WSDSB-hub/EmbodiedVision/DRL-Obstacle-Avoidance/drl design.md

## 方向三：基于深度强化学习的自主导航

### 目标
在PyBullet物理仿真环境中，使用PPO（Proximal Policy Optimization）深度强化学习算法训练一个智能体，使其学会在障碍物环境中自主避障并到达目标位置。探索AI与机器人控制的交叉领域，为后续Sim-to-Real部署奠定基础。

### 为什么选择强化学习？
在方向六中，避障决策使用的是基于规则的状态机：检测到障碍物在左侧就右转，在右侧就左转。这套规则在简单场景下有效，但存在三个局限：
1. 无法处理复杂场景（如多个障碍物同时出现）。
2. 规则的阈值（安全距离0.5米）需要人工调试，泛化能力差。
3. 遇到未曾预料的场景时完全无法应对。

强化学习的核心优势在于：不需要人工编写规则，智能体通过在环境中反复试错，自己学会最优策略。这正是从"人工编程"走向"自主智能"的关键一步。

### 技术架构

#### 仿真环境：PyBullet
选择PyBullet而非Gazebo的原因：
- 轻量级，安装简单，无需ROS依赖。
- 支持DIRECT模式（无GUI渲染），训练速度比Gazebo快10倍以上。
- 内置`plane.urdf`、`r2d2.urdf`、`cube_small.urdf`等基础模型，开箱即用。

#### 强化学习框架：Gymnasium + Stable-Baselines3
- **Gymnasium**：OpenAI维护的强化学习环境标准接口。自定义环境只需实现`reset()`和`step()`两个方法，即可无缝对接所有主流算法。
- **Stable-Baselines3**：封装了PPO、SAC、A2C等算法的稳定实现。我们选择PPO的原因：
  - 适合离散动作空间（本项目的3个动作）。
  - 训练稳定，不易崩溃（相比DQN等值函数方法）。
  - 超参数不敏感，适合初次尝试强化学习的新手。

#### 状态空间设计
状态空间是3维连续向量，范围[0, 10]，代表小车前方三个方向（左前、正前、右前）的距离传感器读数。设计考量：
- 3维是最小可行的观测维度。更高维度（如摄像头图像）需要CNN策略网络，训练成本大幅增加。
- 距离传感器与实物小车的深度估计输出天然对应，便于后续Sim-to-Real迁移。

#### 动作空间设计
动作空间是3个离散动作：0=前进，1=左转，2=右转。设计考量：
- 与实物小车的控制指令（'w', 'a', 'd'）一一对应。
- 离散动作比连续动作（如目标转速值）更容易训练，收敛更快。

#### 奖励函数设计
奖励函数是强化学习中最关键的设计决策。本环境的奖励规则：
- 到达终点（x>5.0）：+10
- 碰撞障碍物（距离<0.3米）：-10
- 正常前进：`-0.1 × min_dist + 1.0`

第三项的设计逻辑：距离障碍物越远，奖励越高（最高+1.0）。乘以0.1是为了让单步奖励保持在较小范围，避免梯度爆炸。+1.0的偏置确保前进过程获得正向激励，防止智能体原地不动。

### 训练过程

训练脚本 `train_drl.py` 的核心参数：
- **算法**：PPO
- **策略网络**：MlpPolicy（全连接神经网络，2层64单元）
- **学习率**：0.0003（默认值，适合大多数场景）
- **n_steps**：1024（每次更新前收集的步数）
- **总训练步数**：100,000

训练在PyBullet的DIRECT模式下运行，无需GUI渲染。在我的笔记本上完成10万步训练仅需几分钟，比Gazebo仿真快一个数量级。

### 测试结果

运行 `test_drl.py` 进行200步测试，关键数据：
- **累计奖励**：+62.04
- **终止原因**：到达终点（第90步获得+10奖励）
- **主要行为**：模型选择了以右转为主的绕行策略

累计奖励远高于0，说明模型确实学会了避障。但它并没有掌握灵活转向——大多数时候它只是"一直右转"。这不代表训练失败，而是反映了当前环境设计的局限性。

### 诚实分析：模型的局限与根源

模型学到的策略之所以比较单一，根源在于仿真环境过于简单：
1. 只有2个静态障碍物，且位置范围有限。
2. 观测空间只有3维距离值，缺少方向信息，模型无法判断障碍物在左边还是右边。
3. 10万步训练对于复杂策略可能不够充分。

但这并不意味着方向三没有价值。恰恰相反，这个过程完整展示了强化学习项目的标准流程——环境设计、算法选择、训练监控、结果分析、改进方向——这正是研究生阶段做科研的核心能力。

### 后续改进方向

1. **丰富环境复杂度**
   - 增加障碍物数量（从2个到5-10个）。
   - 随机化障碍物的初始位置和大小。
   - 引入动态障碍物（移动的方块）。

2. **改进观测空间**
   - 将3维距离改为5维或7维，覆盖更广的前方视野。
   - 加入小车当前位置和目标位置，让模型学会全局路径规划。

3. **Sim-to-Real部署**
   - 将训练好的PPO模型导出为ONNX格式。
   - 在实物小车上加载模型，用深度估计的输出作为观测输入。
   - 对比规则式避障与强化学习避障的成功率和路径效率。

4. **算法升级**
   - 尝试SAC（Soft Actor-Critic），适合连续动作空间，可实现更平滑的转向。
   - 使用LSTM策略网络处理时间序列信息。

### 产出
- `models/ppo_avoidance_model.zip`：训练好的PPO模型
- `src/drl_avoidance_env.py`：自定义Gym环境（含完整的状态/动作/奖励定义）
- `src/train_drl.py`：训练脚本（含PPO超参数配置）
- `src/test_drl.py`：测试脚本（输出每步动作和累计奖励）
- `src/pybullet_test.py`：仿真环境验证脚本
- `images/pybullet_env.png`：PyBullet仿真环境截图
