WSDSB-hub/EmbodiedVision/05-Visual-Perception/yolo_detection image/3745dec2737d3145f0a43bfdfe77ebf4.png

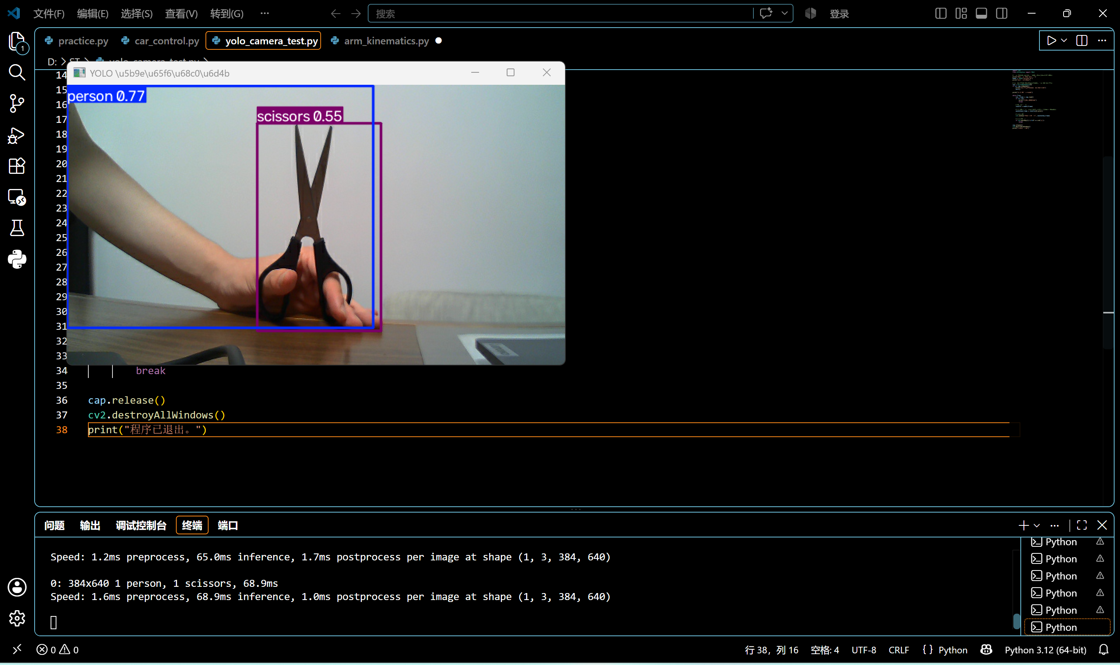
05-Visual-Perception/yolo_detection image/3745dec2737d3145f0a43bfdfe77ebf4.png
