WSDSB-hub/EmbodiedVision/05-Visual-Perception/yolo_detection image/10291ce72935a3f45005688cc83b20e0.png

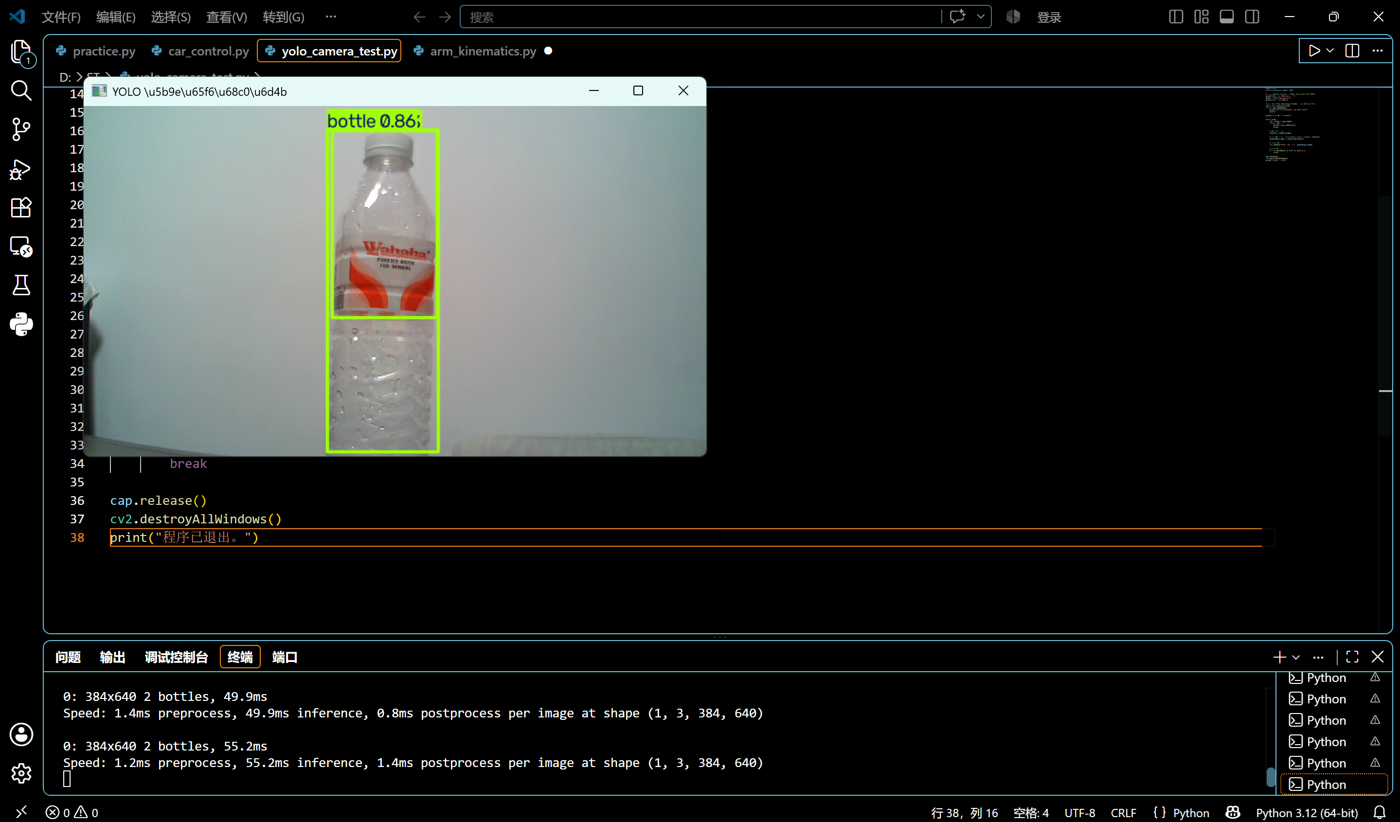
05-Visual-Perception/yolo_detection image/10291ce72935a3f45005688cc83b20e0.png
