WSDSB-hub/EmbodiedVision/DRL-Obstacle-Avoidance/pybullet_env.png

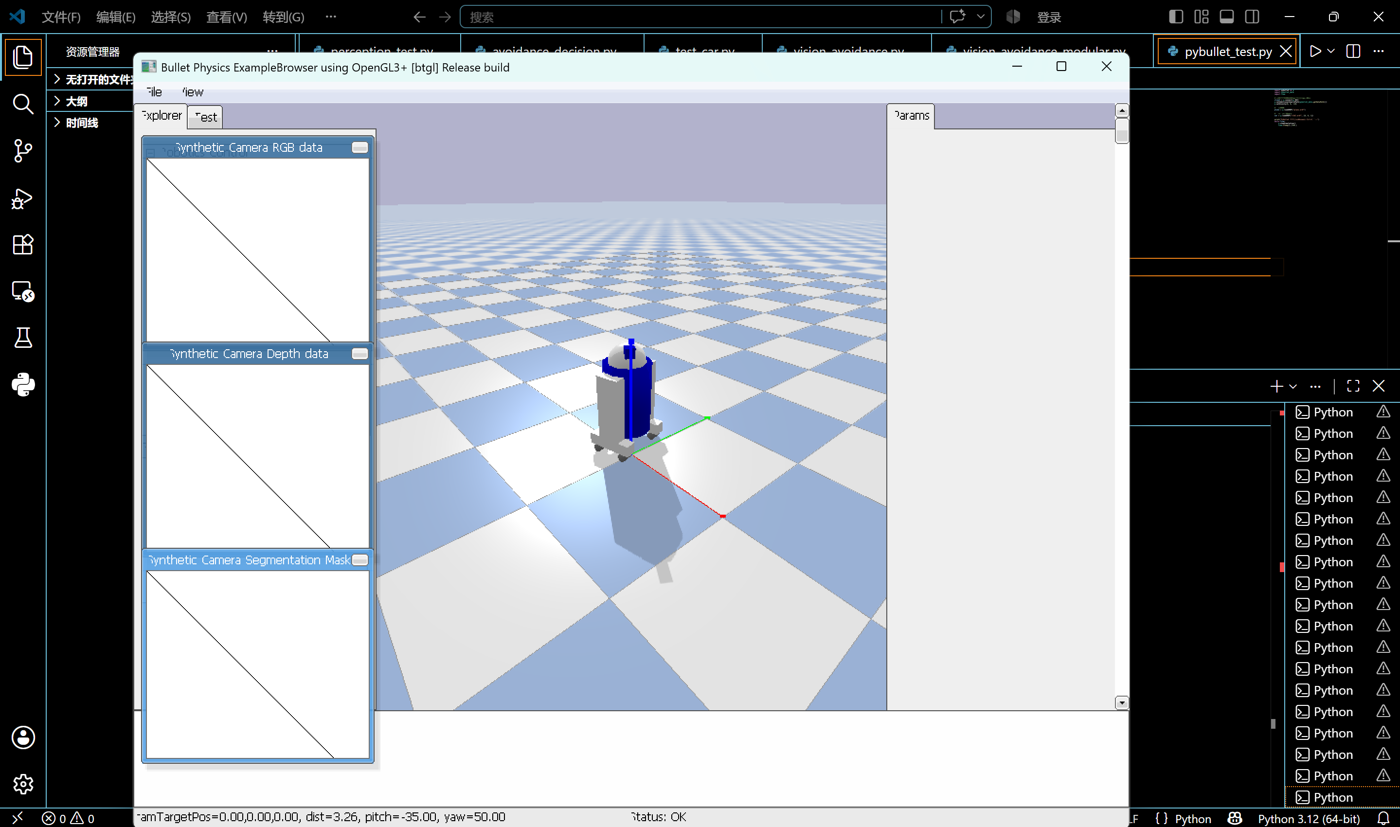
DRL-Obstacle-Avoidance/pybullet_env.png
