WSDSB-hub/EmbodiedVision/vision_pkg/vision_pkg/image publisher and subscriber.png

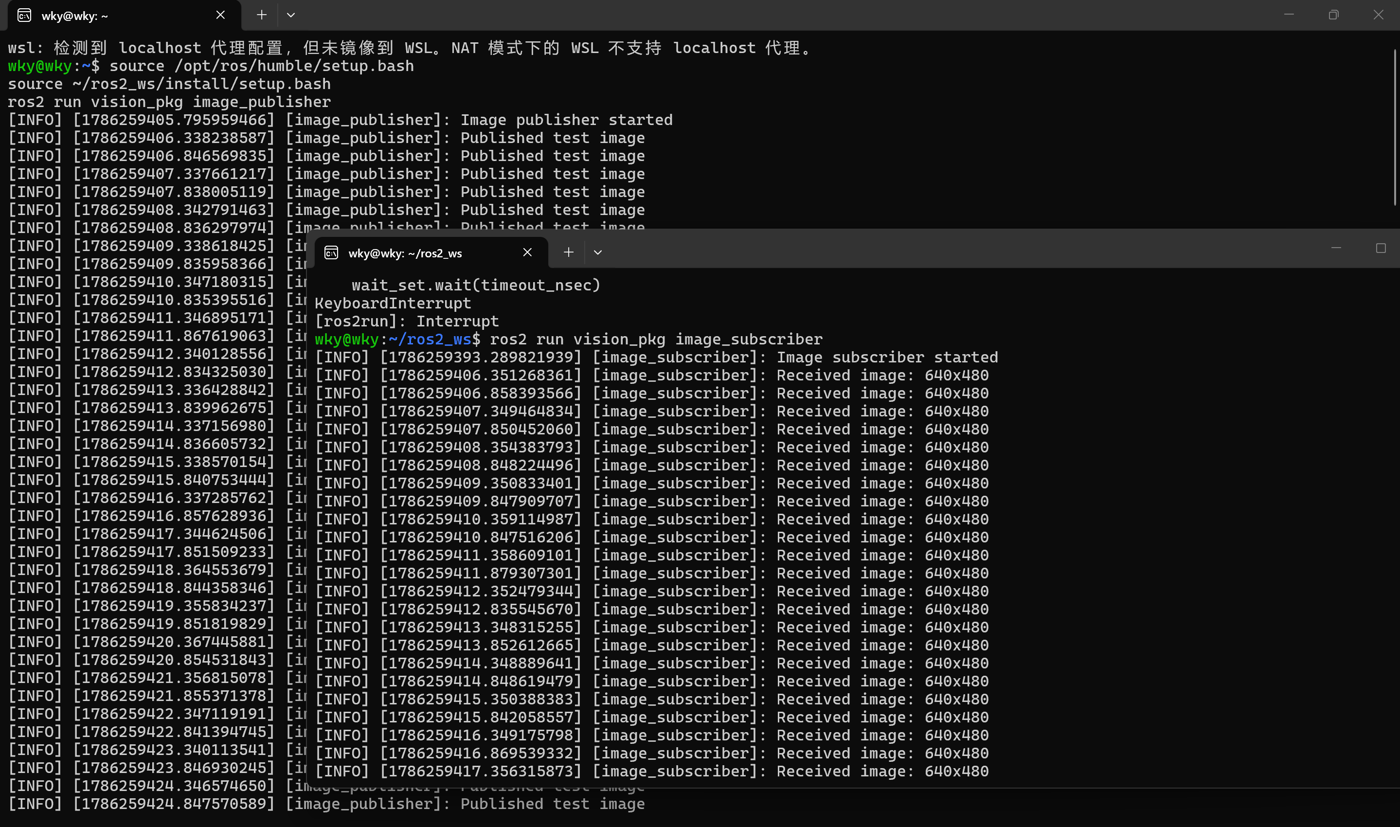
vision_pkg/vision_pkg/image publisher and subscriber.png
