WSDSB-hub/EmbodiedVision/01-Hardware-Setup/hardware setup(2).png

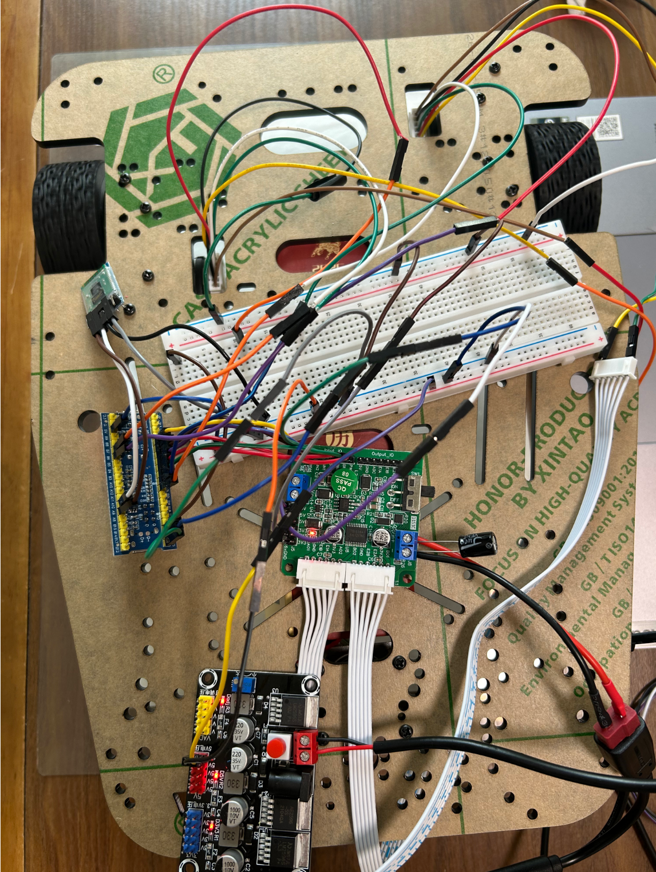
01-Hardware-Setup/hardware setup(2).png
