WSDSB-hub/EmbodiedVision/04-Serial-Protocol/serial protocol test.png

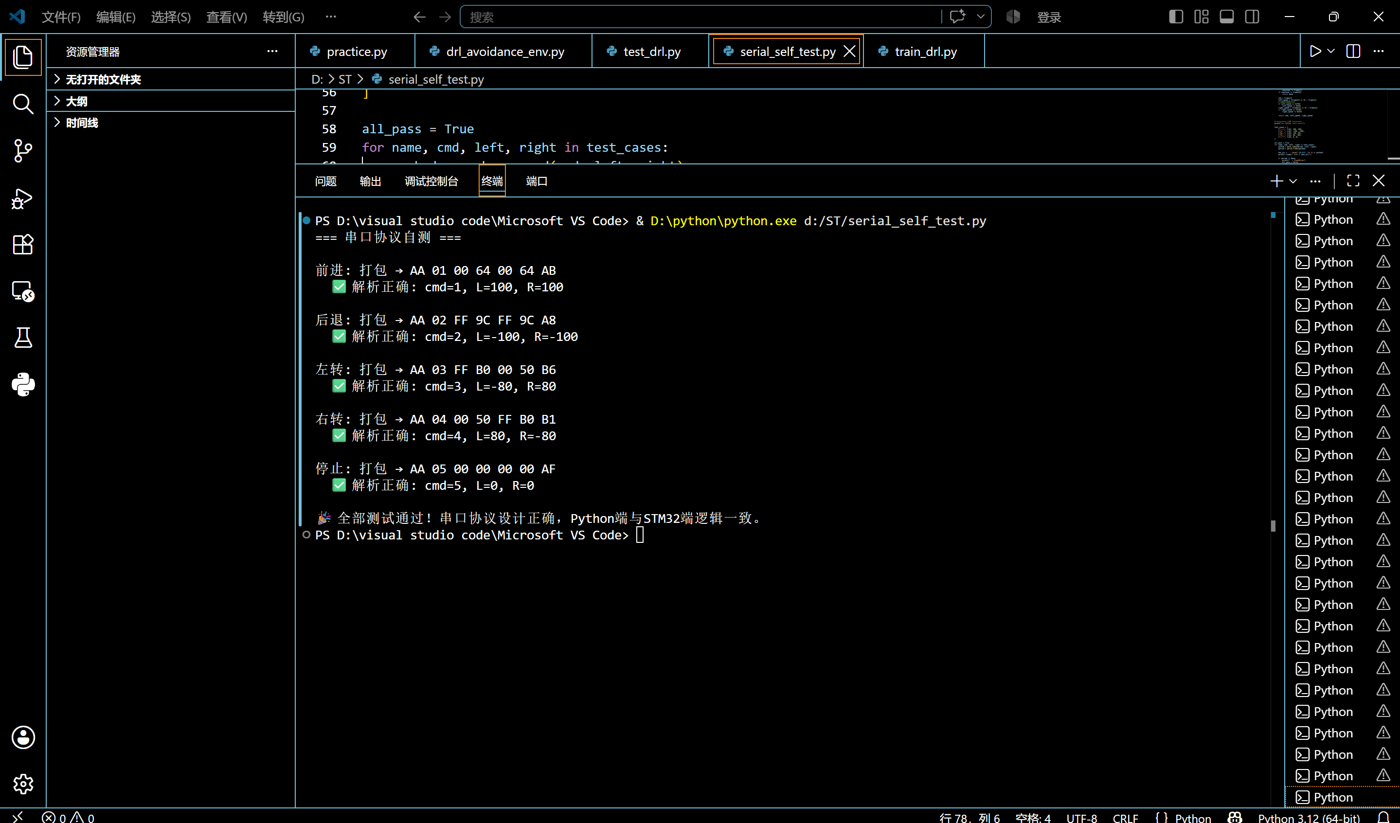
04-Serial-Protocol/serial protocol test.png
