WSDSB-hub/EmbodiedVision/05-Visual-Perception/depth_result image/5b46ab0efe99fd05fd456c35dd674b6e.png

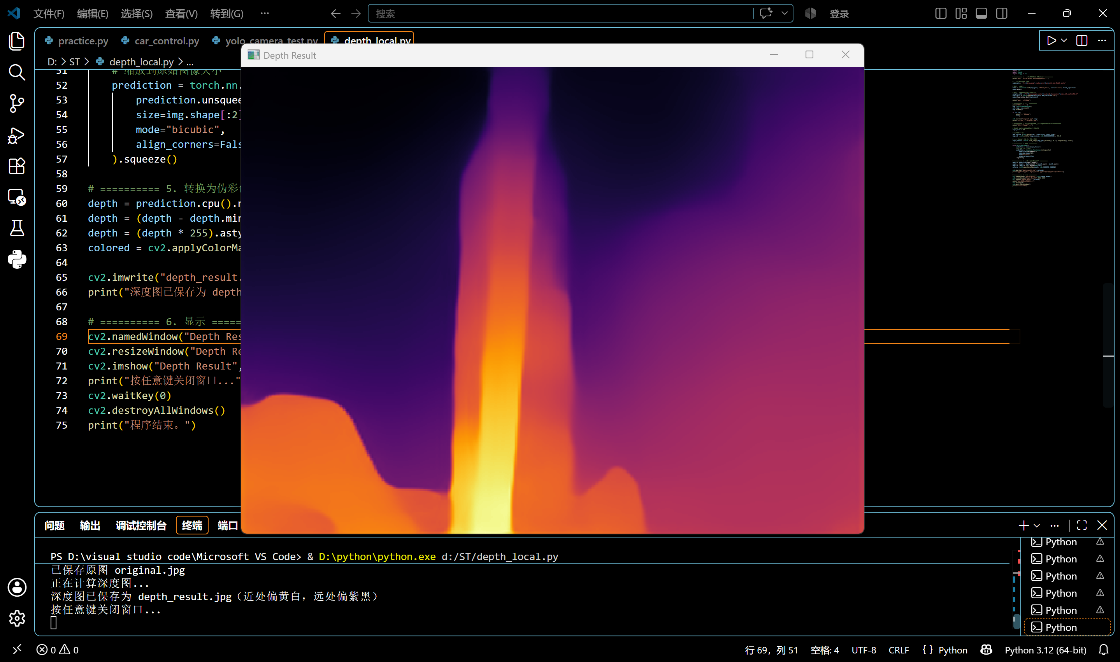
05-Visual-Perception/depth_result image/5b46ab0efe99fd05fd456c35dd674b6e.png
