WSDSB-hub/EmbodiedVision/05-Visual-Perception/depth_result image/c488f6ab571cf79846c9f93154ac484e.png

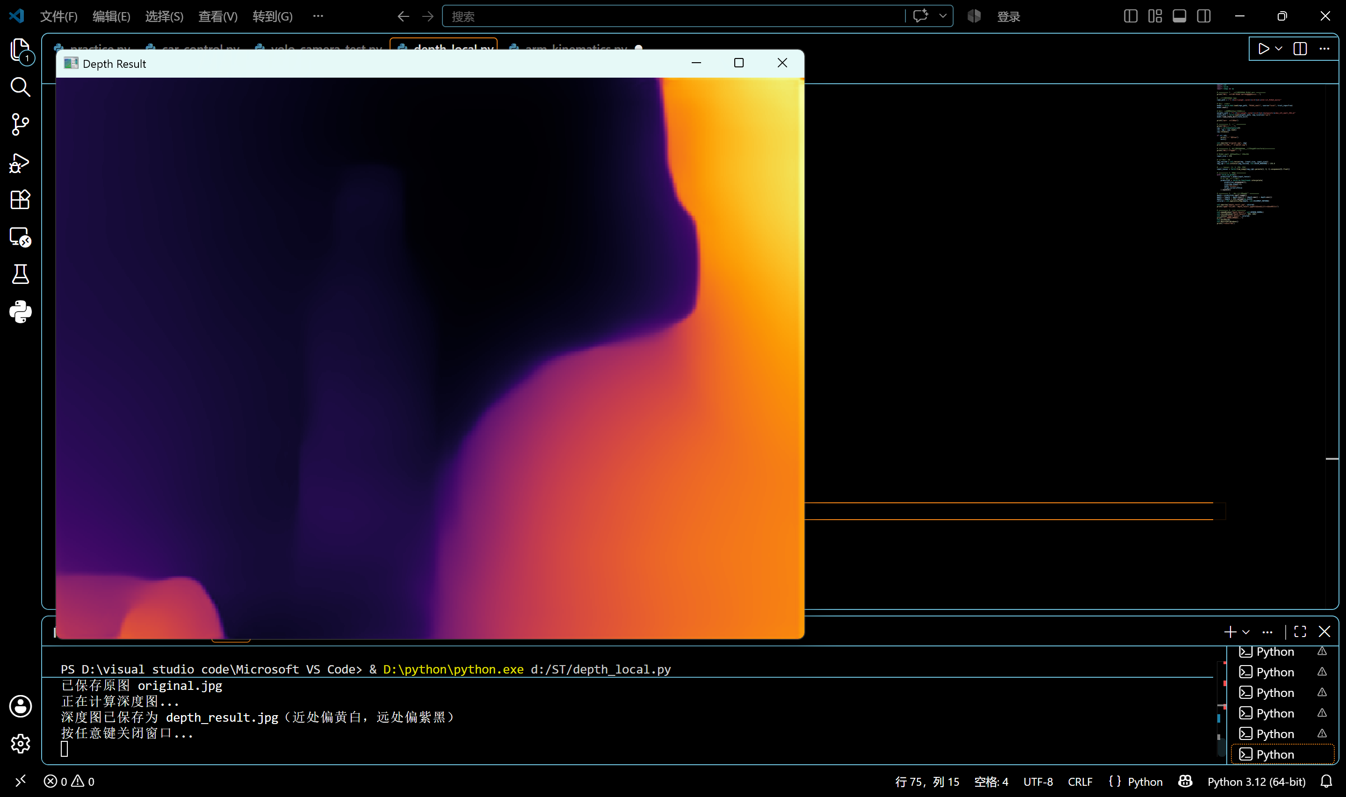
05-Visual-Perception/depth_result image/c488f6ab571cf79846c9f93154ac484e.png
