WSDSB-hub/EmbodiedVision/05-Visual-Perception/depth_result image/ed015eefcad42e6531cd074528ec0791.png

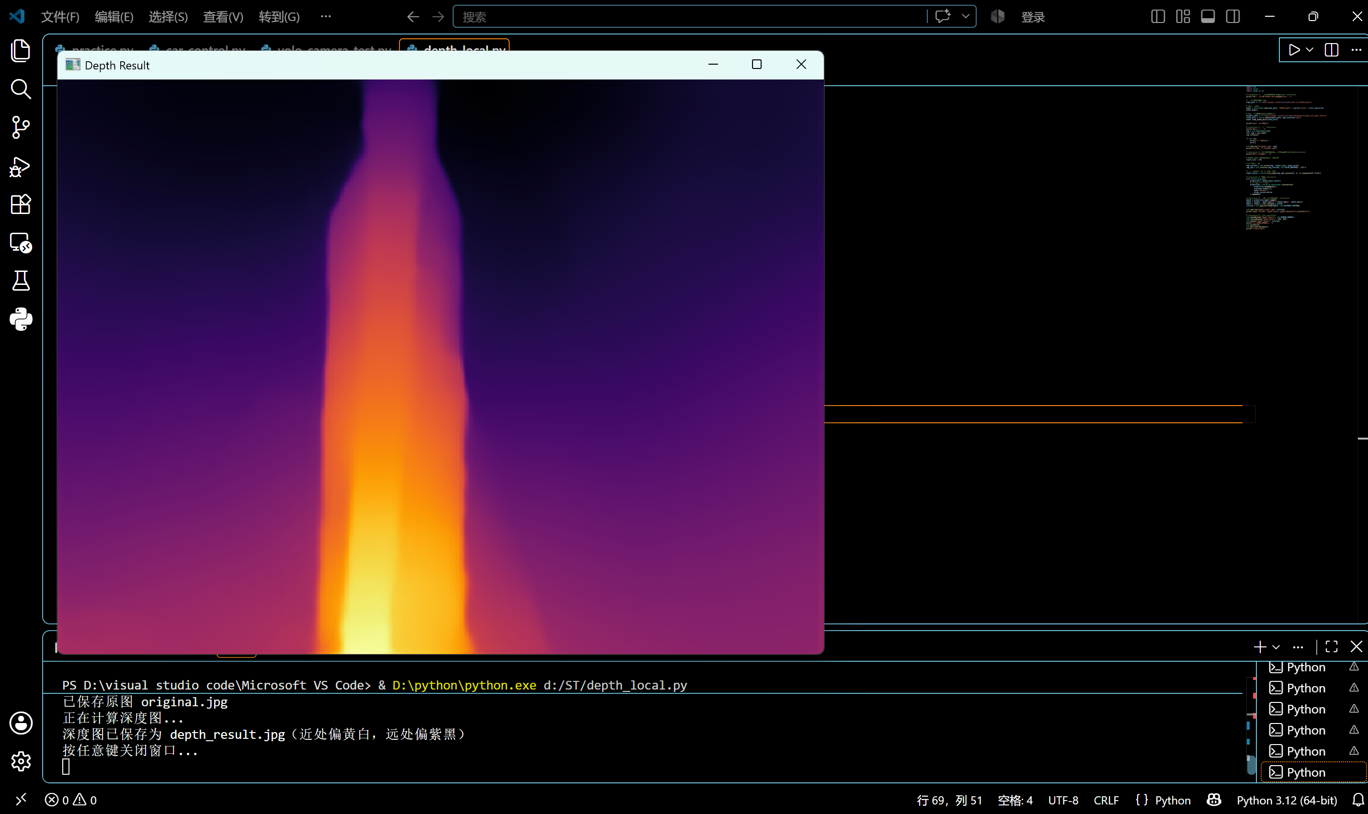
05-Visual-Perception/depth_result image/ed015eefcad42e6531cd074528ec0791.png
