WSDSB-hub/EmbodiedVision/06-Autonomous-Avoidance/avoidance_result.png

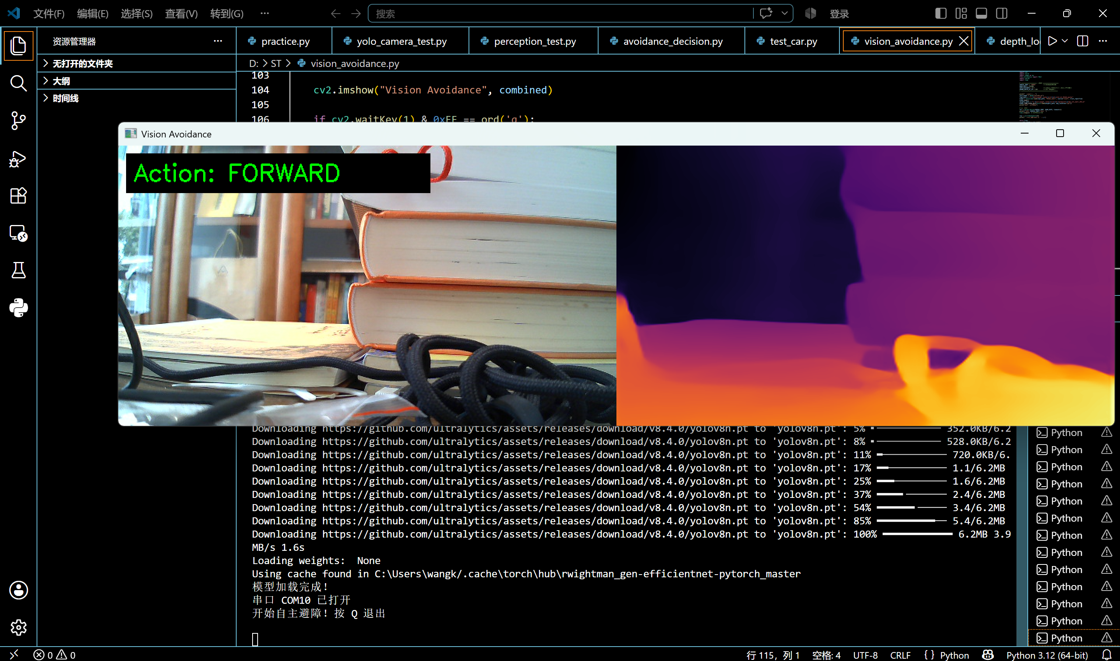
06-Autonomous-Avoidance/avoidance_result.png
