WSDSB-hub/EmbodiedVision/DRL-Obstacle-Avoidance/drl_test_result（1）.png

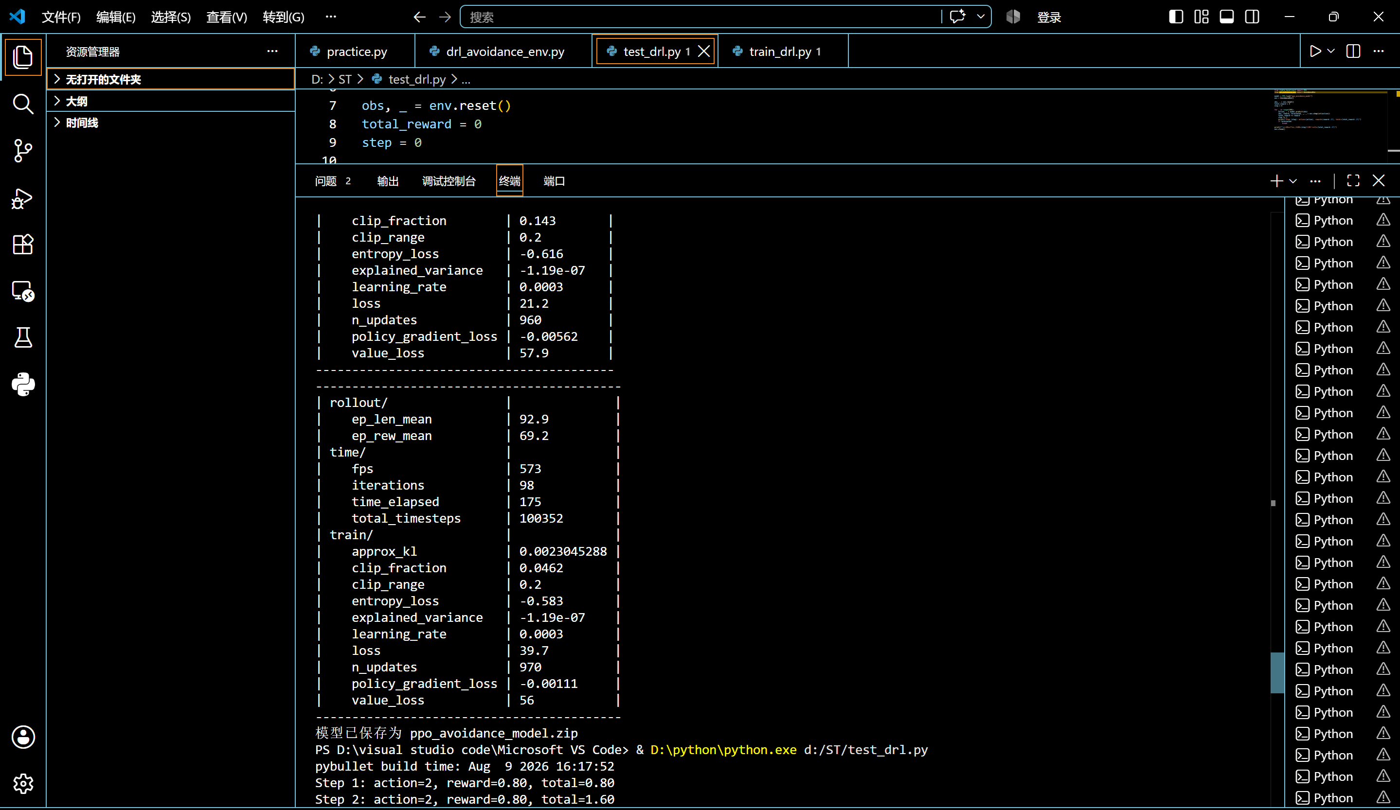
DRL-Obstacle-Avoidance/drl_test_result（1）.png
