WSDSB-hub/EmbodiedVision/DRL-Obstacle-Avoidance/drl_test_result（2）.png

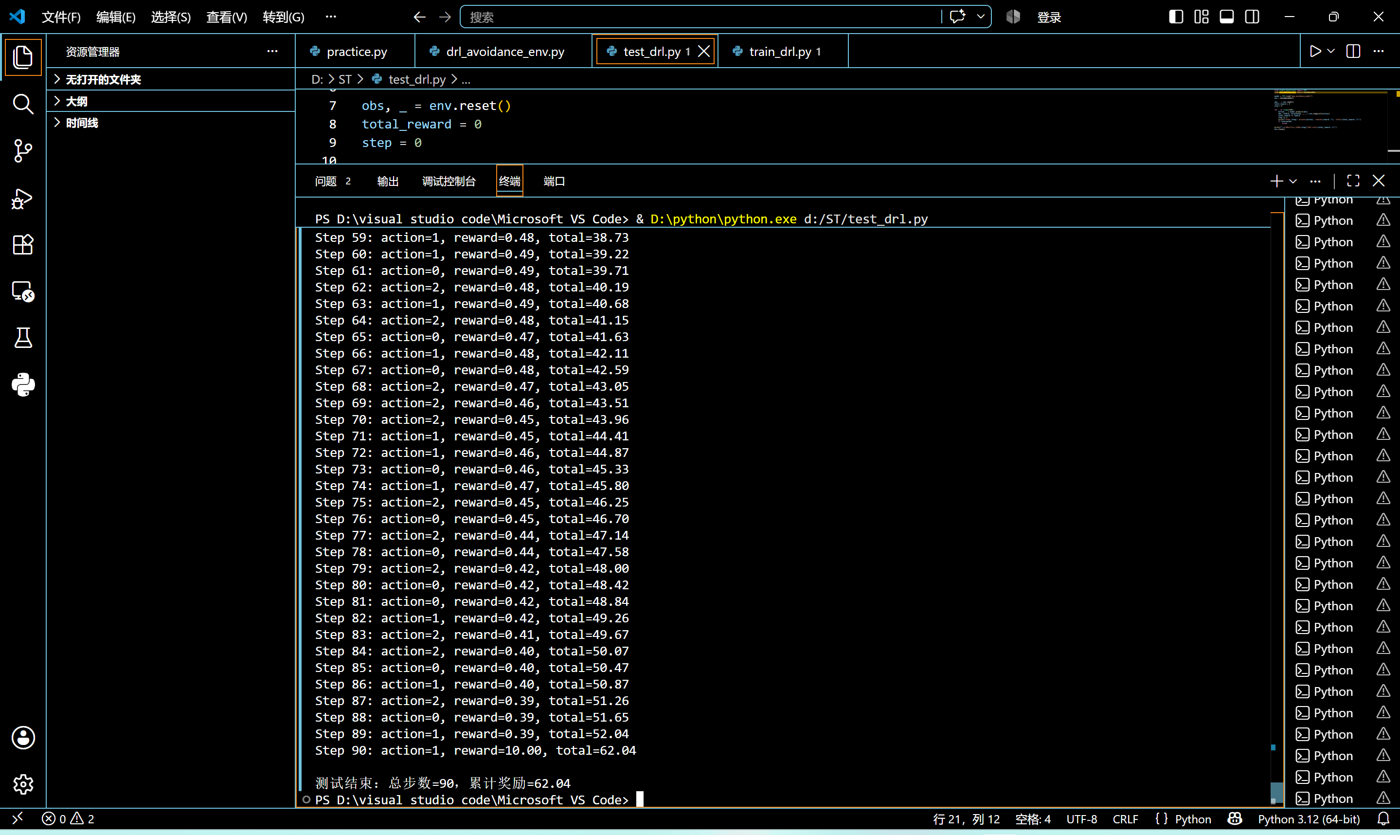
DRL-Obstacle-Avoidance/drl_test_result（2）.png
