WSDSB-hub/EmbodiedVision/04-Serial-Protocol/03_Car_Serial/Core/Src/main.c

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
/* Includes ------------------------------------------------------------------*/
#include "main.h"

/* USER CODE BEGIN Includes */
#include <stdio.h>
#include <string.h>
/* USER CODE END Includes */

TIM_HandleTypeDef htim1;
TIM_HandleTypeDef htim2;
TIM_HandleTypeDef htim3;
TIM_HandleTypeDef htim4;

UART_HandleTypeDef huart1;

/* USER CODE BEGIN PV */
typedef struct {
    float Kp, Ki, Kd;
    float target;
    float error, last_error;
    float integral;
    float output;
    float output_max;
} PID;

PID pid;
volatile float current_rpm = 0;
volatile uint8_t pid_ready = 0;
#define PULSES_PER_REV 1456.0f

// 串口接收缓冲区（用于轮询）
volatile uint8_t uart_rx_buf[7];
volatile uint8_t uart_rx_index = 0;
volatile uint8_t uart_rx_complete = 0;

/* USER CODE END PV */

void SystemClock_Config(void);
static void MX_GPIO_Init(void);
static void MX_TIM1_Init(void);
static void MX_TIM2_Init(void);
static void MX_TIM3_Init(void);
static void MX_TIM4_Init(void);
static void MX_USART1_UART_Init(void);
/* USER CODE BEGIN 0 */
void PID_Calc(PID *p, float current)
{
    if (p->target == 0.0f) {
        p->output = 0.0f;
        p->integral = 0.0f;
        p->last_error = 0.0f;
        return;
    }

    p->error = p->target - current;
    p->integral += p->error;
    if (p->integral > 500.0f) p->integral = 500.0f;
    if (p->integral < -100.0f) p->integral = -100.0f;

    float output = 275.0f;
    output += p->Kp * p->error;
    output += p->Ki * p->integral;
    output += p->Kd * (p->error - p->last_error);
    if (output > 900.0f) output = 900.0f;
    if (output < 0.0f)   output = 0.0f;

    p->output = output;
    p->last_error = p->error;
}

// 指令解析（统一用 pid）
void Parse_Command(void)
{
  if (uart_rx_complete)
  {
    uart_rx_complete = 0;
    uint8_t cmd = uart_rx_buf[1];
    int16_t left_speed = (uart_rx_buf[2] << 8) | uart_rx_buf[3];
    int16_t right_speed = (uart_rx_buf[4] << 8) | uart_rx_buf[5];

    switch (cmd)
    {
      case 0x01:
        pid.target = left_speed;
        HAL_GPIO_WritePin(GPIOA, GPIO_PIN_2, GPIO_PIN_SET);
        HAL_GPIO_WritePin(GPIOA, GPIO_PIN_3, GPIO_PIN_RESET);
        HAL_GPIO_WritePin(GPIOA, GPIO_PIN_4, GPIO_PIN_SET);
        HAL_GPIO_WritePin(GPIOA, GPIO_PIN_5, GPIO_PIN_RESET);
        break;
      case 0x05:
        pid.target = 0;
        break;
    }
  }
}
/* USER CODE END 0 */

/**
  * @brief  The application entry point.
  * @retval int
  */
int main(void)
{

  /* MCU Configuration--------------------------------------------------------*/

  /* Reset of all peripherals, Initializes the Flash interface and the Systick. */
  HAL_Init();

  /* Configure the system clock */
  SystemClock_Config();

  /* Initialize all configured peripherals */
  MX_GPIO_Init();
  MX_TIM1_Init();
  MX_TIM2_Init();
  MX_TIM3_Init();
  MX_TIM4_Init();
  MX_USART1_UART_Init();
  /* USER CODE BEGIN 2 */
  // 手动开启编码器引脚上拉
  GPIOA->ODR |= (GPIO_PIN_6 | GPIO_PIN_7);
  GPIOB->ODR |= (GPIO_PIN_6 | GPIO_PIN_7);

  // 启动编码器和PWM
  HAL_TIM_Encoder_Start(&htim3, TIM_CHANNEL_ALL);
  HAL_TIM_Encoder_Start(&htim4, TIM_CHANNEL_ALL);
  HAL_TIM_PWM_Start(&htim2, TIM_CHANNEL_1);
  HAL_TIM_PWM_Start(&htim2, TIM_CHANNEL_2);
  HAL_TIM_Base_Start_IT(&htim1);

  // PID参数
  pid.Kp = 2.5f;
  pid.Ki = 0.2f;
  pid.Kd = 0.1f;
  pid.target = 0.0f;
  pid.output_max = 999.0f;
  pid.integral = 0;
  pid.last_error = 0;

  // 方向：正转
  HAL_GPIO_WritePin(GPIOA, GPIO_PIN_2, GPIO_PIN_SET);
  HAL_GPIO_WritePin(GPIOA, GPIO_PIN_3, GPIO_PIN_RESET);
  HAL_GPIO_WritePin(GPIOA, GPIO_PIN_4, GPIO_PIN_SET);
  HAL_GPIO_WritePin(GPIOA, GPIO_PIN_5, GPIO_PIN_RESET);

  // 启动消息
  char *msg = "READY\r\n";
  HAL_UART_Transmit(&huart1, (uint8_t*)msg, strlen(msg), HAL_MAX_DELAY);
  /* USER CODE END 2 */

  /* Infinite loop */
  /* USER CODE BEGIN WHILE */
  while (1)
  {
	  // ========== 串口轮询接收 ==========
	    if (__HAL_UART_GET_FLAG(&huart1, UART_FLAG_RXNE))
	    {
	      char cmd = (char)(huart1.Instance->DR & 0xFF);

	      switch (cmd)
	      {
	        case 'w':  // 前进
	          HAL_GPIO_WritePin(GPIOA, GPIO_PIN_2, GPIO_PIN_SET);
	          HAL_GPIO_WritePin(GPIOA, GPIO_PIN_3, GPIO_PIN_RESET);
	          HAL_GPIO_WritePin(GPIOA, GPIO_PIN_4, GPIO_PIN_SET);
	          HAL_GPIO_WritePin(GPIOA, GPIO_PIN_5, GPIO_PIN_RESET);
	          __HAL_TIM_SET_COMPARE(&htim2, TIM_CHANNEL_1, 300);
	          __HAL_TIM_SET_COMPARE(&htim2, TIM_CHANNEL_2, 300);
	          break;

	        case 's':  // 后退
	          HAL_GPIO_WritePin(GPIOA, GPIO_PIN_2, GPIO_PIN_RESET);
	          HAL_GPIO_WritePin(GPIOA, GPIO_PIN_3, GPIO_PIN_SET);
	          HAL_GPIO_WritePin(GPIOA, GPIO_PIN_4, GPIO_PIN_RESET);
	          HAL_GPIO_WritePin(GPIOA, GPIO_PIN_5, GPIO_PIN_SET);
	          __HAL_TIM_SET_COMPARE(&htim2, TIM_CHANNEL_1, 300);
	          __HAL_TIM_SET_COMPARE(&htim2, TIM_CHANNEL_2, 300);
	          break;

	        case 'a':  // 左转（左轮反转，右轮正转）
	          HAL_GPIO_WritePin(GPIOA, GPIO_PIN_2, GPIO_PIN_RESET);
	          HAL_GPIO_WritePin(GPIOA, GPIO_PIN_3, GPIO_PIN_SET);
	          HAL_GPIO_WritePin(GPIOA, GPIO_PIN_4, GPIO_PIN_SET);
	          HAL_GPIO_WritePin(GPIOA, GPIO_PIN_5, GPIO_PIN_RESET);
	          __HAL_TIM_SET_COMPARE(&htim2, TIM_CHANNEL_1, 300);
	          __HAL_TIM_SET_COMPARE(&htim2, TIM_CHANNEL_2, 300);
	          break;

	        case 'd':  // 右转（左轮正转，右轮反转）
	          HAL_GPIO_WritePin(GPIOA, GPIO_PIN_2, GPIO_PIN_SET);
	          HAL_GPIO_WritePin(GPIOA, GPIO_PIN_3, GPIO_PIN_RESET);
	          HAL_GPIO_WritePin(GPIOA, GPIO_PIN_4, GPIO_PIN_RESET);
	          HAL_GPIO_WritePin(GPIOA, GPIO_PIN_5, GPIO_PIN_SET);
	          __HAL_TIM_SET_COMPARE(&htim2, TIM_CHANNEL_1, 300);
	          __HAL_TIM_SET_COMPARE(&htim2, TIM_CHANNEL_2, 300);
	          break;

	        case ' ':  // 停止
	          __HAL_TIM_SET_COMPARE(&htim2, TIM_CHANNEL_1, 0);
	          __HAL_TIM_SET_COMPARE(&htim2, TIM_CHANNEL_2, 0);
	          break;
	      }
	    }
    /* USER CODE END WHILE */
  }
    /* USER CODE BEGIN 3 */
  }
  /* USER CODE END 3 */


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
