WSDSB-hub/EmbodiedVision/(notices)

Notices in the files:
04-Serial-Protocol/03_Car_Serial/Core/Src/main.c:
Copyright (c) 2026 STMicroelectronics.
All rights reserved.
This software is licensed under terms that can be found in the LICENSE file
